Antannah/esp-lowcode-matter/products/grillsensor/doc/pinout seedstudio xiao esp32-c6.jpg

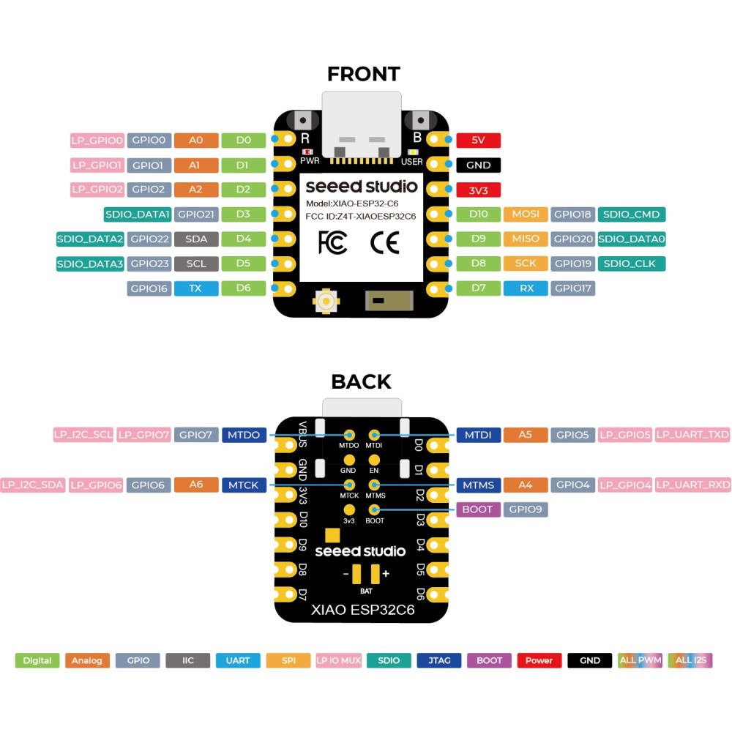
products/grillsensor/doc/pinout seedstudio xiao esp32-c6.jpg
