Antannah/esp-lowcode-matter/products/grillsensor/doc/grillsensor-xiaoesp32-c6-b_Platine.png

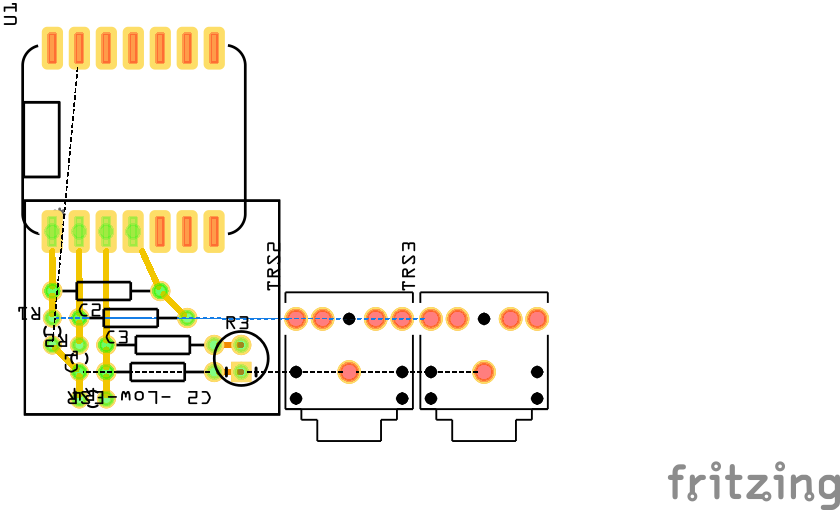
products/grillsensor/doc/grillsensor-xiaoesp32-c6-b_Platine.png
