Antannah/esp-lowcode-matter/products/grillsensor/doc/grillsensor-xiaoesp32-c6-b_bom_bom.pdf

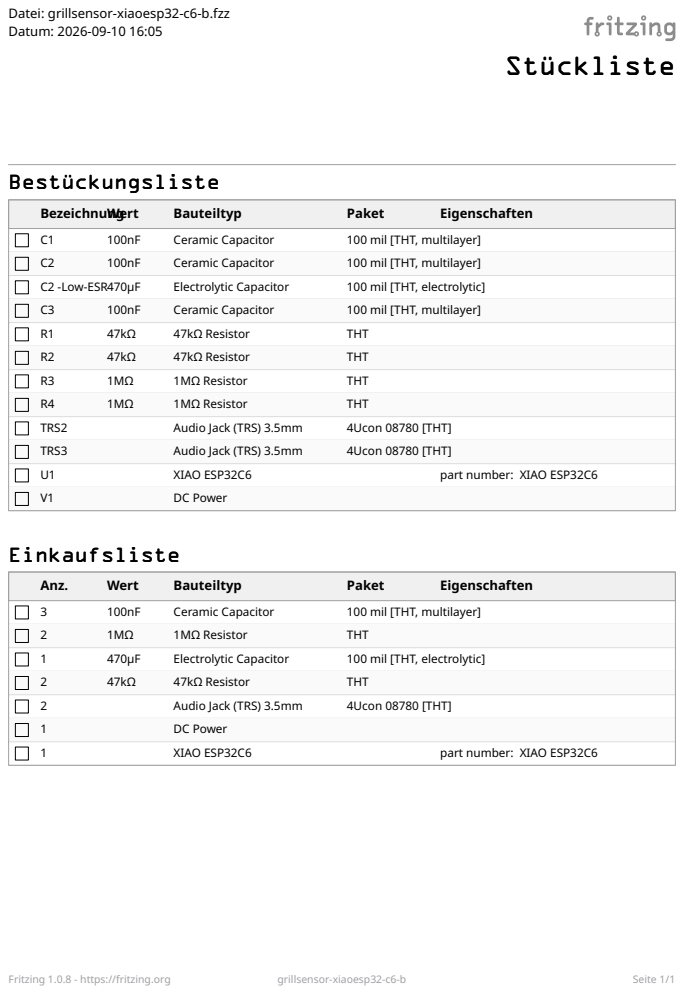
[picture p8: page 1]
