Antannah/esp-lowcode-matter/(list of files, drawings)

Other design files:
products/grillsensor/doc/grillsensor-xiaoesp32-c6-b.fzz
products/grillsensor/doc/grillsensor-xiaoesp32-c6.fzz
