Antannah/esp-lowcode-matter/(commit log)

2026-06-11 fix temperature updates reported to incorrect cluster
2026-08-27 feat: add grillsensor dual temperature sensor
    [provisioning_config.txt]
2026-08-27 fix(grillsensor): use int16_t for Matter MeasuredValue and add 5s periodic timer
    [app_driver.cpp]
2026-08-27 docs: add schematic and hardware documentation for grillsensor
2026-08-27 docs(grillsensor): add hardware schematic, sensor data sheets and fitting script
    [MessungFantast.csv, MessungFantast.xls, Sensor_ACURITE.xls, Sensor_Fantast.xls, Sensor_Maverick.xls]
2026-08-27 feat(grillsensor): add GPIO power-gating and delta/heartbeat reporting
2026-08-27 feat(grillsensor): add battery voltage monitoring via Matter Power Source cluster
2026-08-28 feat(grillsensor): adapt pinout, battery sense, and RF antenna switch for Seeed Studio XIAO ESP32-C6
2026-08-28 docs(grillsensor): rename schematic to lowercase and add Low-ESR bulk capacitor
2026-08-28 docs(grillsensor): add schematics with fritzing
    [grillsensor-xiaoesp32-c6-b.fzz, grillsensor-xiaoesp32-c6-b_bom.csv, grillsensor-xiaoesp32-c6.fzz]
2026-09-02 docs(grillsensor): add power on-off switch via EN/RST to schematic and documentation
2026-09-02 docs(grillsensor): add switch S1 to BOM csv
    [grillsensor-xiaoesp32-c6-b_bom.csv]
2026-09-10 docs: change board size and create BOM
2026-09-10 fix(grillsensor): fix ESP32-C6 SARADC register mapping and conversion readout
    [app_driver.cpp]
2026-09-10 fix(grillsensor): configure SARADC clock tree, sampling delays and print all raw values
    [app_driver.cpp]
2026-09-10 debug(grillsensor): log ADC register status and timeout condition
2026-09-10 debug(grillsensor): disable power-gating, keep D3 permanently HIGH for testing
2026-09-10 debug(grillsensor): unconditionally print raw ADC register values and timeout state
2026-09-10 feat(grillsensor): migrate ADC to official ESP-IDF esp_adc oneshot driver
2026-09-10 fix(grillsensor): use ulp_lp_core_lp_adc driver instead of esp_adc for LP-Core/AMP build
    [app_driver.cpp]
2026-09-10 fix(grillsensor): use hal/adc_ll.h directly to support bare-metal ULP/LP-Core build in ESP-IDF 5.3
    [app_driver.cpp]
2026-09-10 fix(grillsensor): provide esp_rom_delay_us implementation for LP-Core bare-metal linker
    [app_driver.cpp]
2026-09-10 fix(grillsensor): trigger ADC start transition (LOW to HIGH) and wait for conversion event
    [app_driver.cpp]
2026-09-10 fix(grillsensor): enable ADC power domain (xpd_sar_force) and hold start pulse for 20us
    [app_driver.cpp]
